BenHasNoBrain/TheAccordinotreally/Images/20230719_163658.jpg

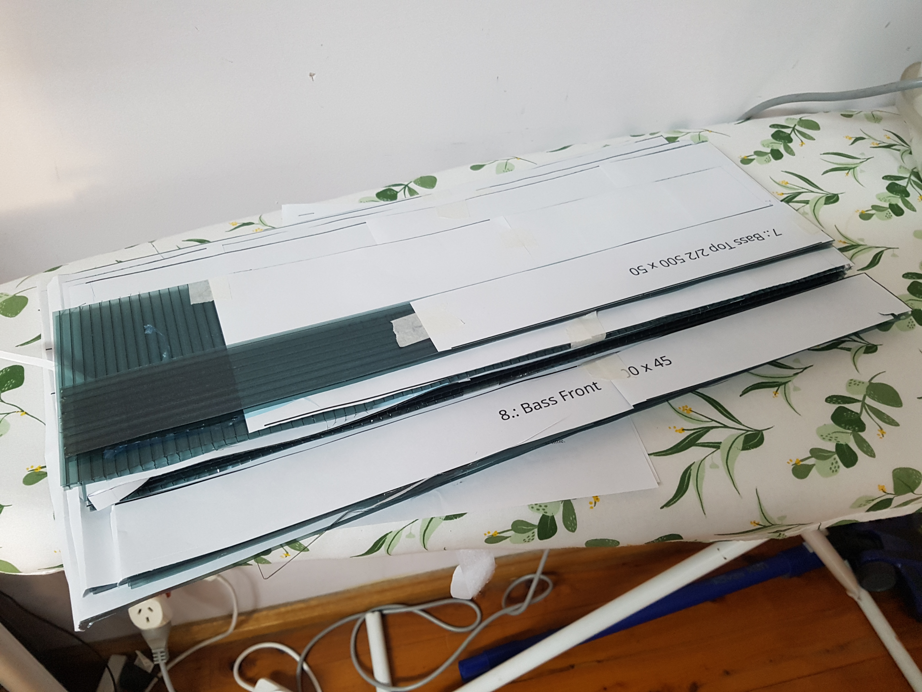
Images/20230719_163658.jpg
