BenHasNoBrain/TheAccordinotreally/Images/20230724_203411.jpg

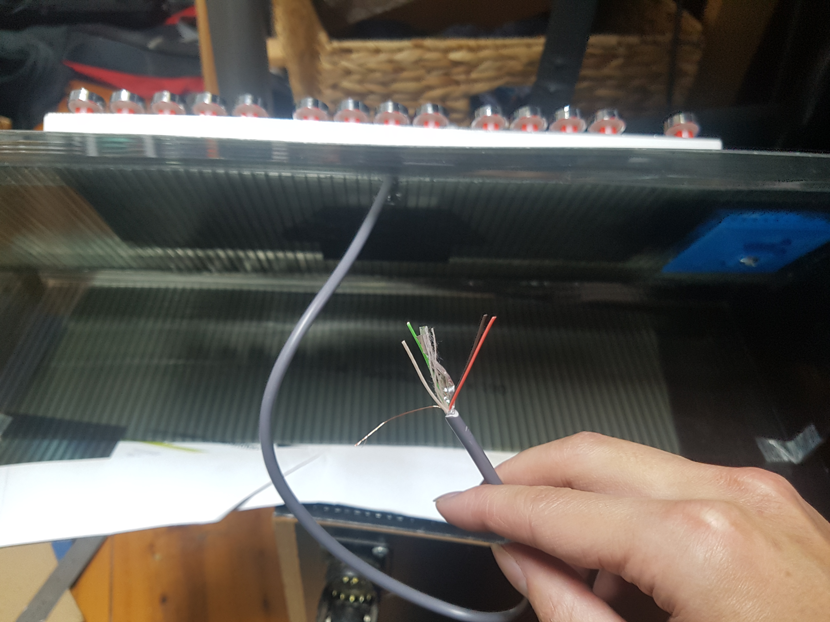
Images/20230724_203411.jpg
