BenHasNoBrain/TheAccordinotreally/Images/20230724_203554.jpg

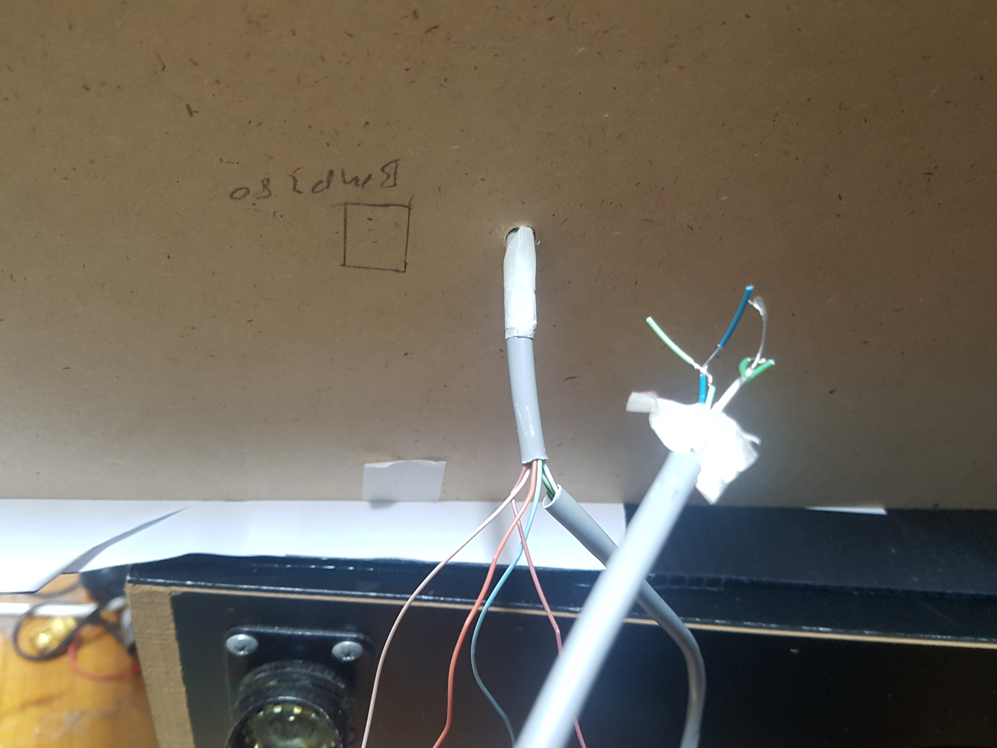
Images/20230724_203554.jpg
