BenHasNoBrain/TheAccordinotreally/Images/IMG_20230606_132842.jpg

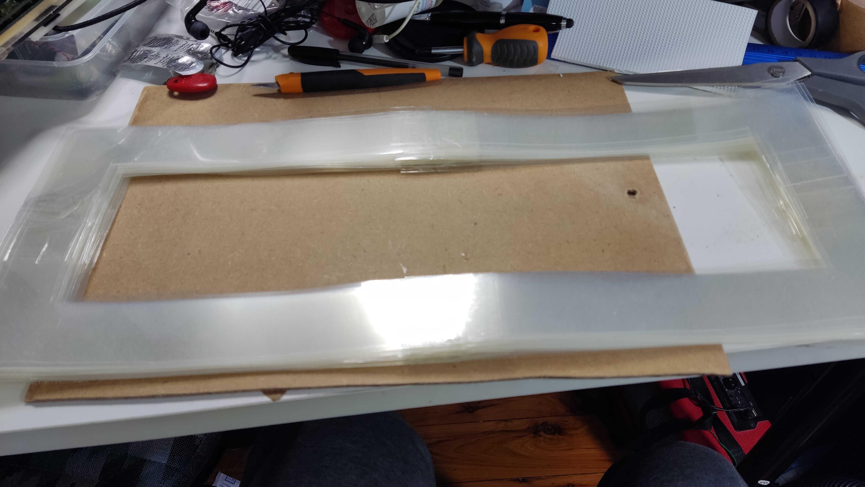
Images/IMG_20230606_132842.jpg
