BenHasNoBrain/TheAccordinotreally/Images/IMG_20230606_132938.jpg

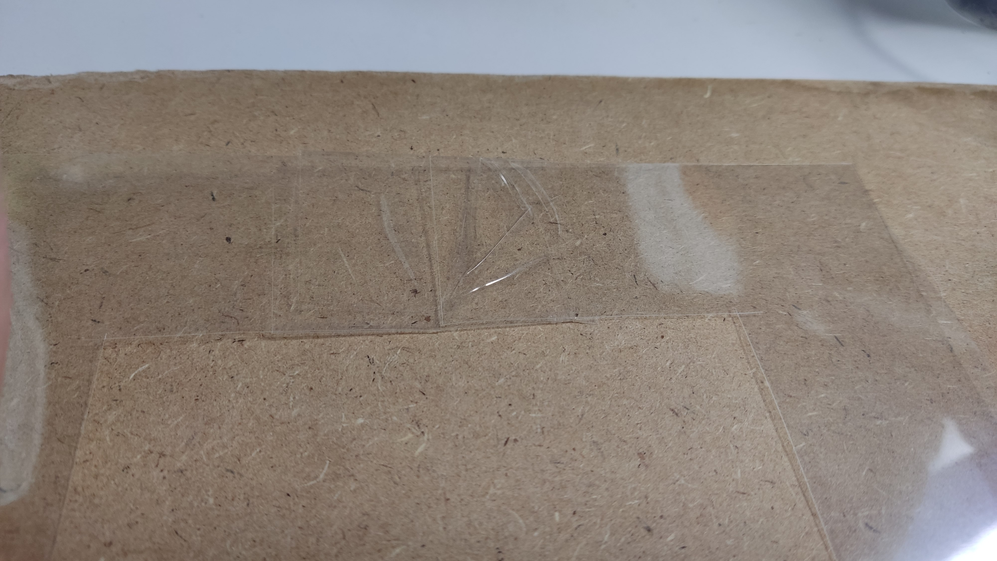
Images/IMG_20230606_132938.jpg
