BenHasNoBrain/TheAccordinotreally/Images/IMG_20230606_211402.jpg

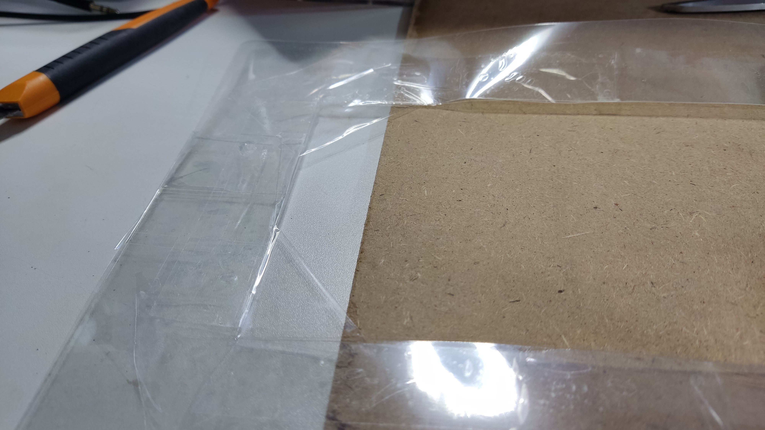
Images/IMG_20230606_211402.jpg
