BenHasNoBrain/TheAccordinotreally/Images/IMG_20230606_211424.jpg

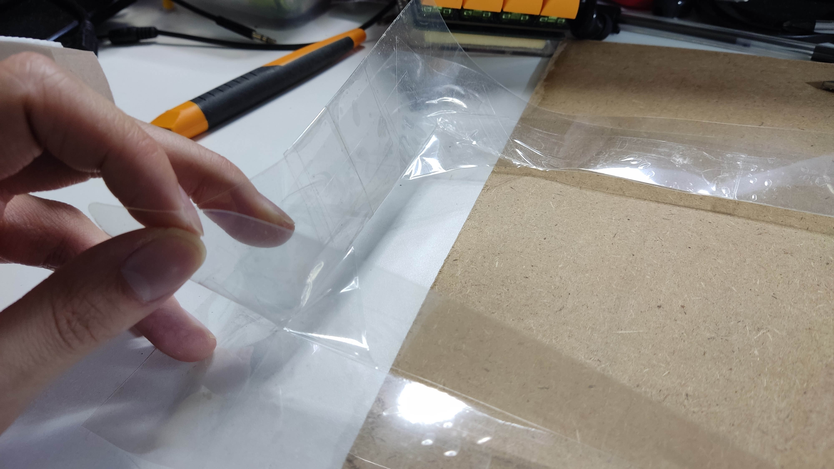
Images/IMG_20230606_211424.jpg
