BenHasNoBrain/TheAccordinotreally/Images/IMG_20230606_211945.jpg

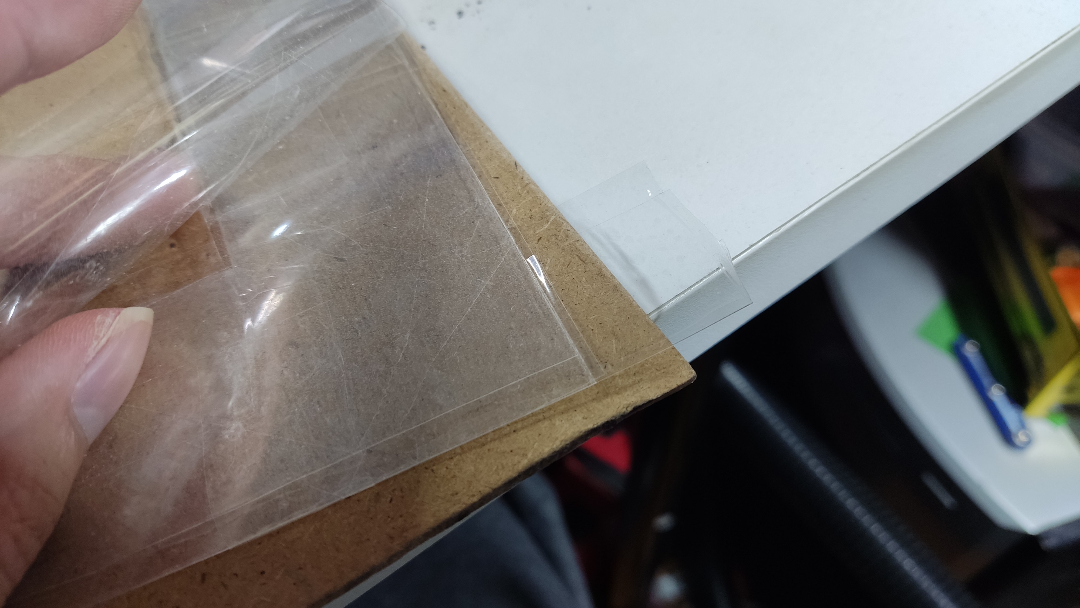
Images/IMG_20230606_211945.jpg
