BenHasNoBrain/TheAccordinotreally/Images/IMG_20230606_212032_1.jpg

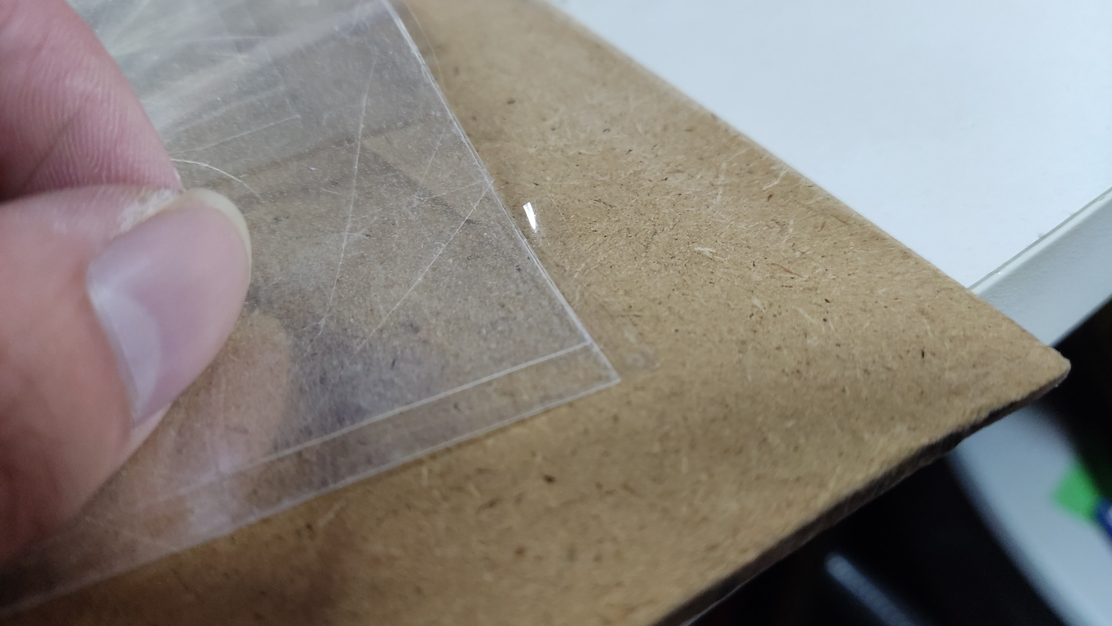
Images/IMG_20230606_212032_1.jpg
