BenHasNoBrain/TheAccordinotreally/Images/IMG_20230606_212110.jpg

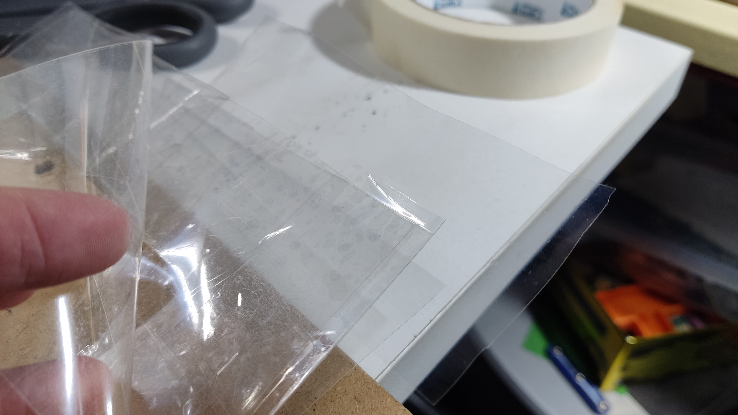
Images/IMG_20230606_212110.jpg
