BenHasNoBrain/TheAccordinotreally/Images/IMG_20230606_212135.jpg

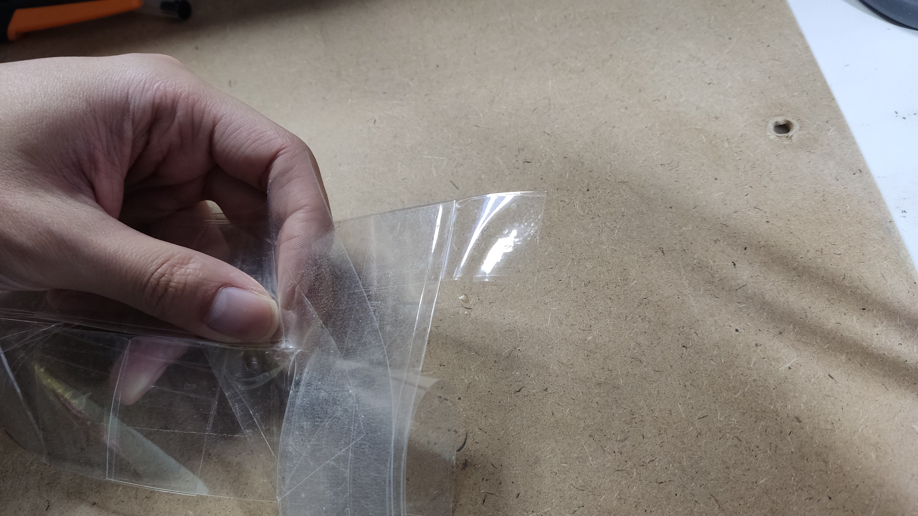
Images/IMG_20230606_212135.jpg
