BenHasNoBrain/TheAccordinotreally/Images/IMG_20230606_212411.jpg

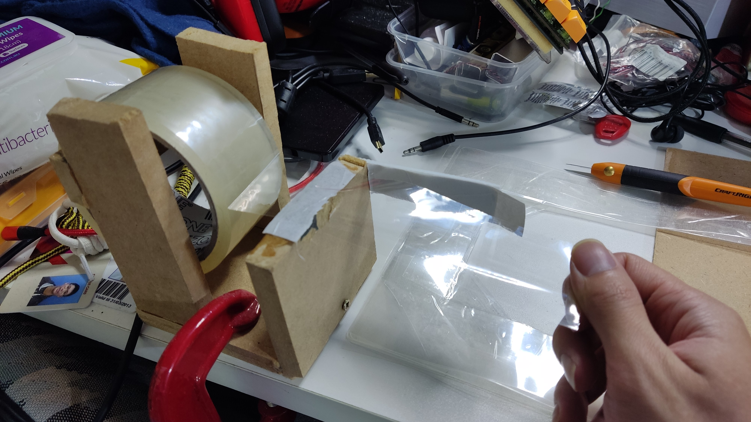
Images/IMG_20230606_212411.jpg
