BenHasNoBrain/TheAccordinotreally/Images/IMG_20230606_212857.jpg

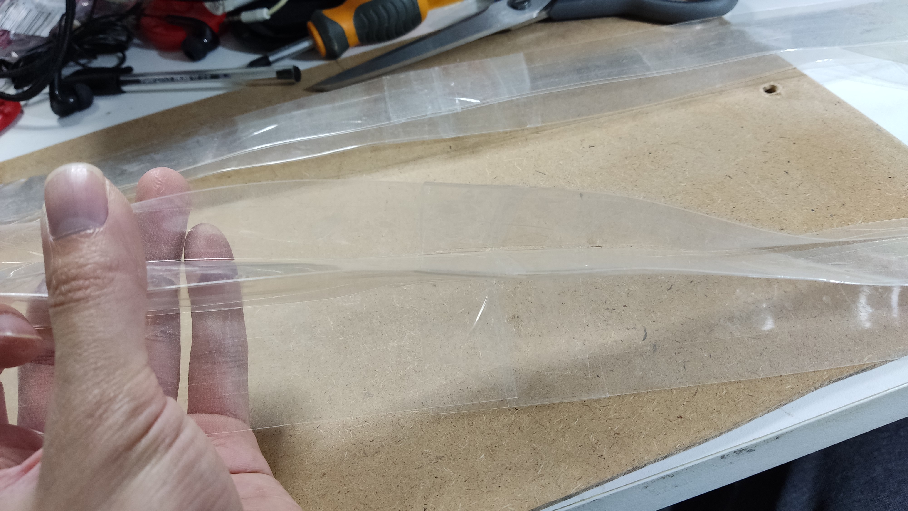
Images/IMG_20230606_212857.jpg
