BenHasNoBrain/TheAccordinotreally/Images/IMG_20230705_123400.jpg

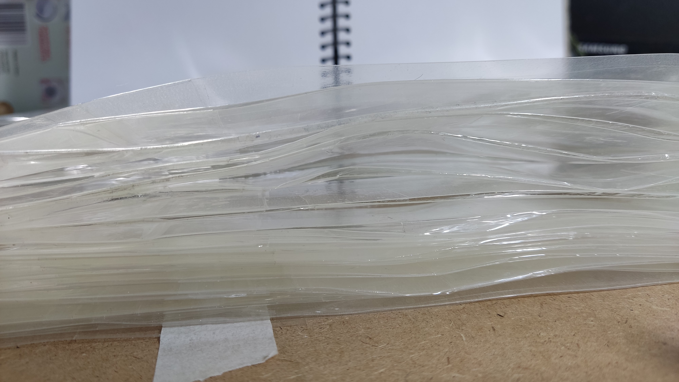
Images/IMG_20230705_123400.jpg
