BenHasNoBrain/TheAccordinotreally/Images/IMG_20230726_230929.jpg

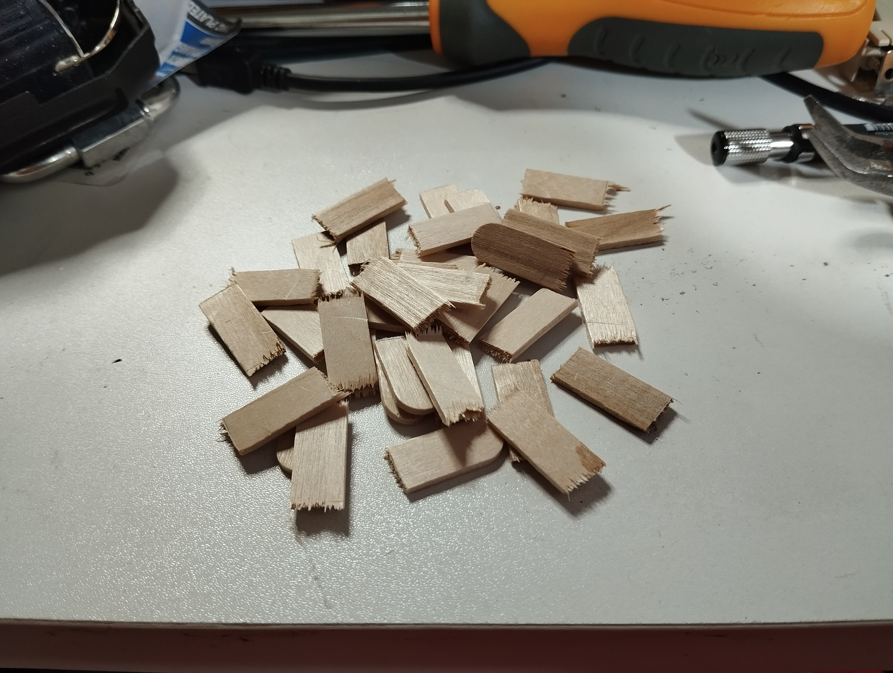
Images/IMG_20230726_230929.jpg
