BenHasNoBrain/TheAccordinotreally/Images/IMG_20230726_233108.jpg

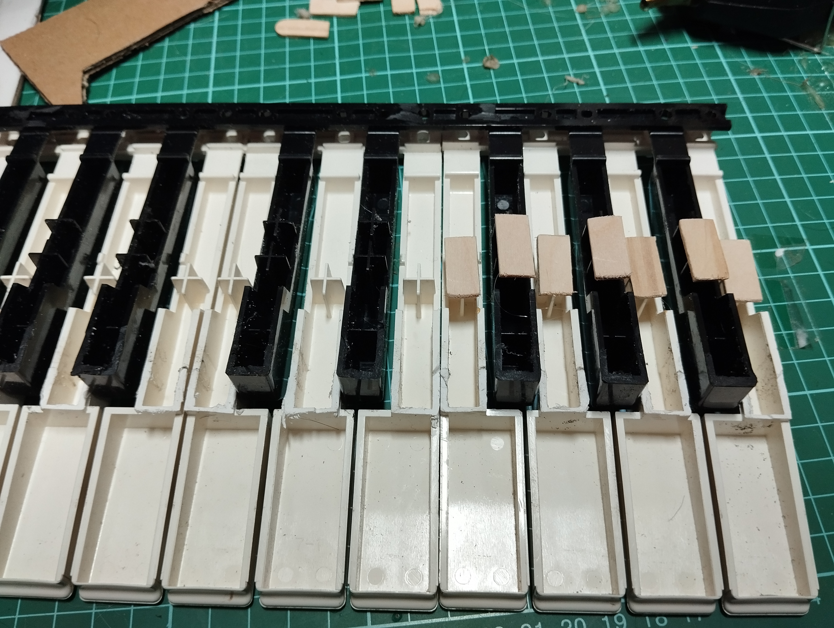
Images/IMG_20230726_233108.jpg
