BenHasNoBrain/TheAccordinotreally/Images/IMG_20230726_233129.jpg

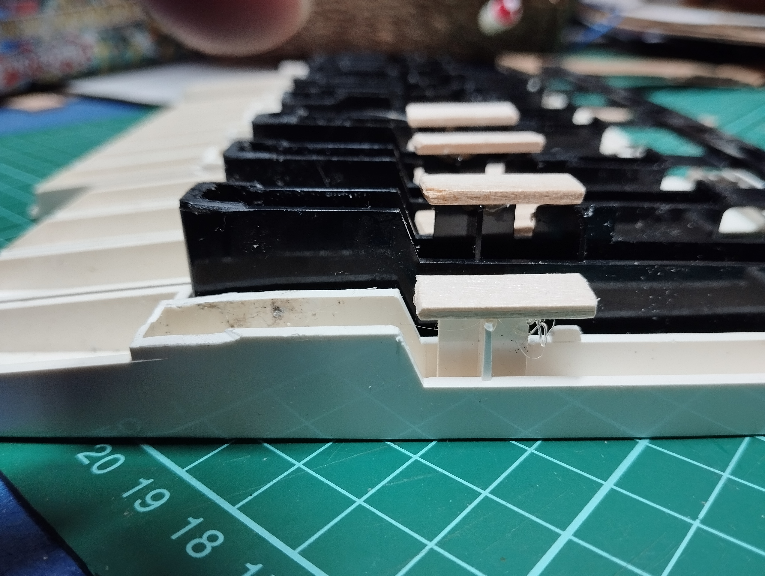
Images/IMG_20230726_233129.jpg
