BenHasNoBrain/TheAccordinotreally/Images/IMG_20230726_233142.jpg

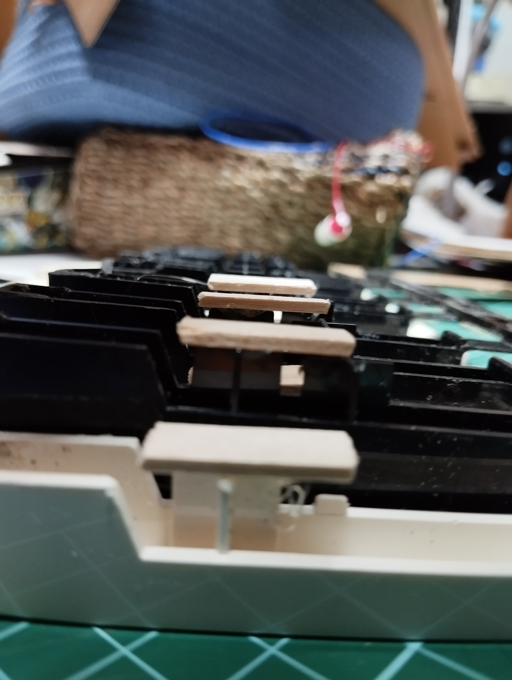
Images/IMG_20230726_233142.jpg
