BenHasNoBrain/TheAccordinotreally/Accordinot_Code/Accord_Display.ino

unsigned long tme;
unsigned long paniktme;

void setup_Display()  {
  //21 characters wide, at regular settings
  display.begin(SSD1306_SWITCHCAPVCC, 0x3C);
  display.clearDisplay();
  display.setTextColor(WHITE);
  display.setTextSize(1);
  display.setFont(NULL);

  tme = millis();
}

void display_stuff()  {
  if ((millis() - tme) > 10)  {
    display.clearDisplay();
    display.setCursor(0, 3);
    display.println("The Accordinotreally");
    display.drawLine(0, 14, 127, 14, 1);
    display.setCursor(0, 20);
    switch (dispMode) {
      case 0:
        display.print("Pitch: "); display.print(keyModifier); display.print(" | Vol:"); display.print(mainVolume);
        break;
      case 1:
        display.print("Bellows: "); display.print(bellowsMode); display.print(" | PS: "); display.print(pressureSensitivity);
        break;
      case 2:
        display.print("p0: "); display.print(pressureZero); display.print("  |  val: "); display.print(abs(currentPressure - pressureDiff));
        break;
      case 3:
        display_bass();
        break;
      case 4:
        display_pressure();
        break;
    }
    
    display.display();


    display_panik();

    tme = millis();
  }
}

void display_bass() {
  display.clearDisplay();
  display.setCursor(0, 5);
    
  for (byte i = 0; i < 5; i++)  {
    display.print(bassOn[i]); display.print(", ");
  }
  display.setCursor(0, 15);
  for (byte i = 0; i < 5; i++)  {
    display.print(bassOff[i]); display.print(", ");
  }
  display.setCursor(0, 15);
}

void display_panik()  {
  if (panikMode)  {
    display.clearDisplay();
    display.setCursor(0, 0);
    display.print("PANIK!!!");
    display.display();
    tme = millis() + 1100;
    panikMode = false;
  }
}

void display_pressure() {
  display.clearDisplay();
  display.setCursor(0, 5);
  display.print(press1 - 100000); display.print(" | "); display.print(press2 - 100000);
  display.setCursor(0, 15);
  display.print(currentPressure); display.print(" | "); display.print(pressureVelocity);
  display.setCursor(0, 25);
  display.print(pressureDiff);
}
