BenHasNoBrain/TheAccordinotreally/(commit log)

2023-08-12 First commit containing 3 weeks of code, working prototype
2023-08-13 Begin reworking the Bass system, specifically scanning and MIDI sending
    [Accord_Bass.ino, Accord_Display.ino, Accord_KB.ino, Accord_Midi.ino, Accord_Pressure.ino, Accordinot_Code.ino]
2023-08-20 Odd bug with Bass getting hung, seems to be working at this moment.
    [Accord_Bass.ino, Accord_Midi.ino, Accordinot_Code.ino]
2023-08-20 Sorta fixed Bass hanging problem by RP2040 settings, see Accord_Midi: 78
    [Accord_Bass.ino, Accord_Midi.ino, Accordinot_Code.ino]
2023-08-20 Modifications to pressure sensing + displaying
2023-08-28 Attempt at fixing pressure system via aftertouch -> controlChange. Reimplemented panik button.
    [Accord_Bass.ino, Accord_Midi.ino]
2023-08-31 Making changes to the pressure system
2023-09-04 Merged branches, revamping pressure system.
2023-09-07 Added second pressure sensor + related code.
